Nobcha/R909-VFO-GPS/R909-VFO_GPS_connect3.jpg

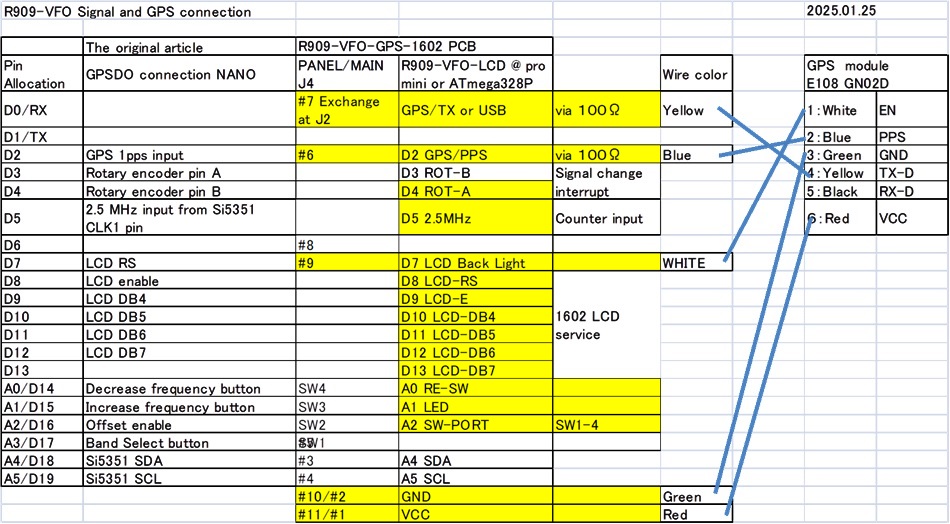
R909-VFO_GPS_connect3.jpg
