Nobcha/R909-VFO-GPS/R909-VFO_GPS_connect2.jpg

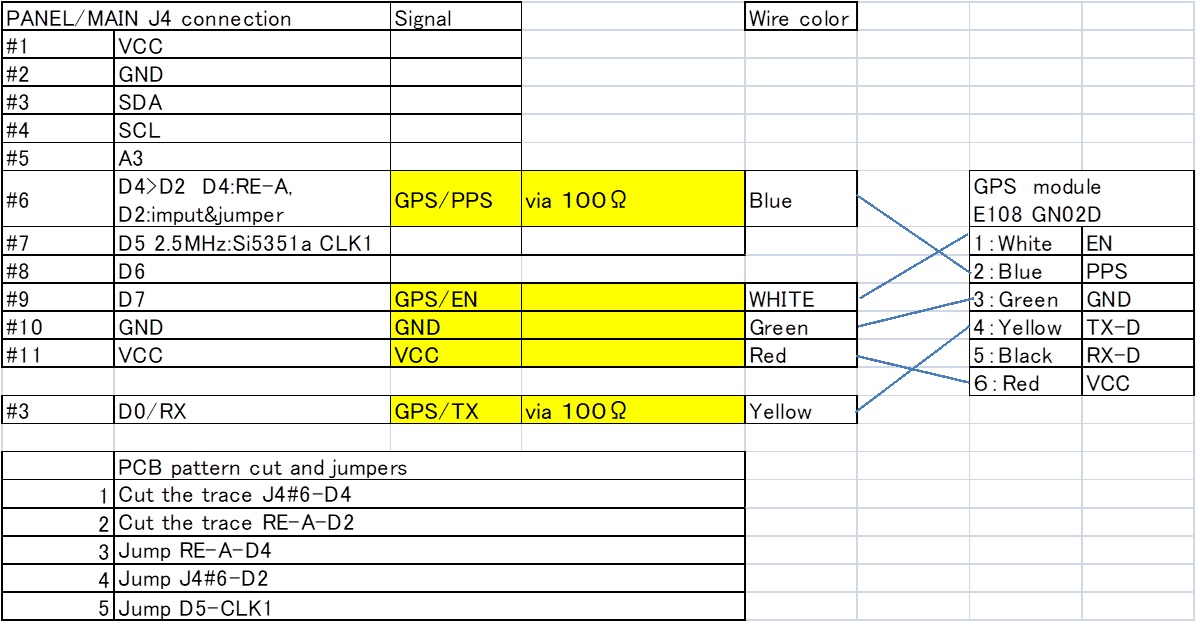
R909-VFO_GPS_connect2.jpg
