Nobcha/R909-VFO-GPS/R909-VFO_GPS_connection.jpg

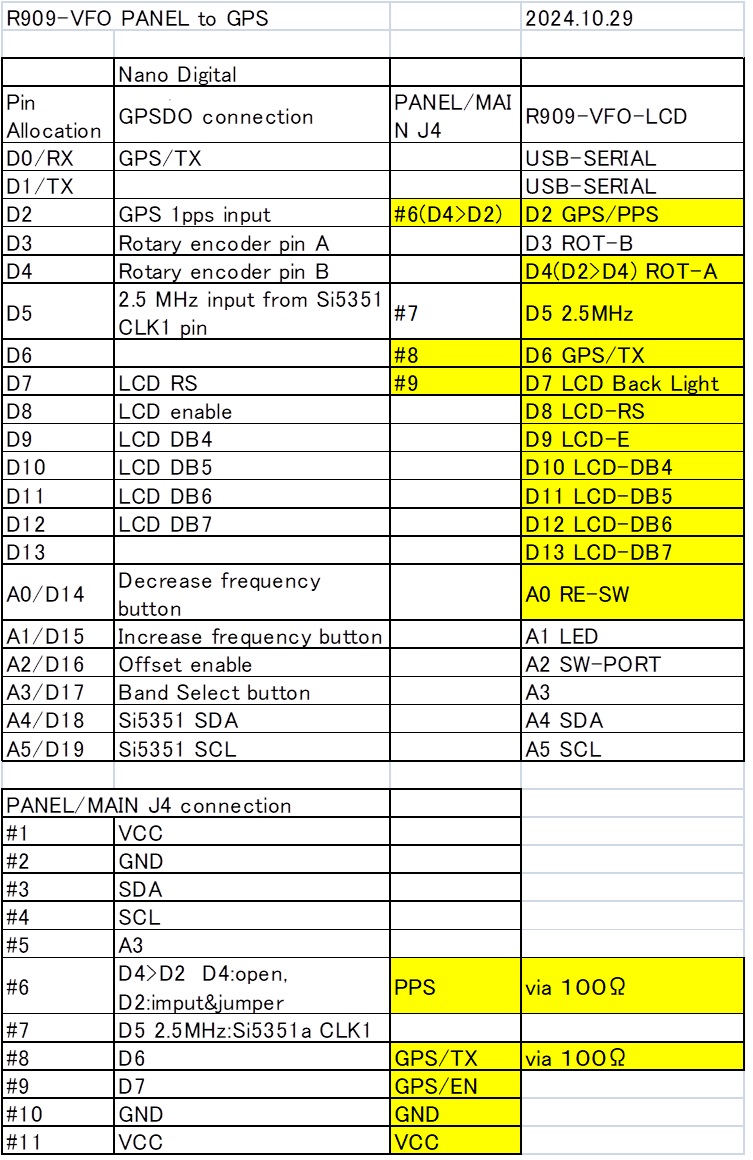
R909-VFO_GPS_connection.jpg
