Nobcha/R909-VFO-GPS/R909-VFO_GPS_bom.jpg

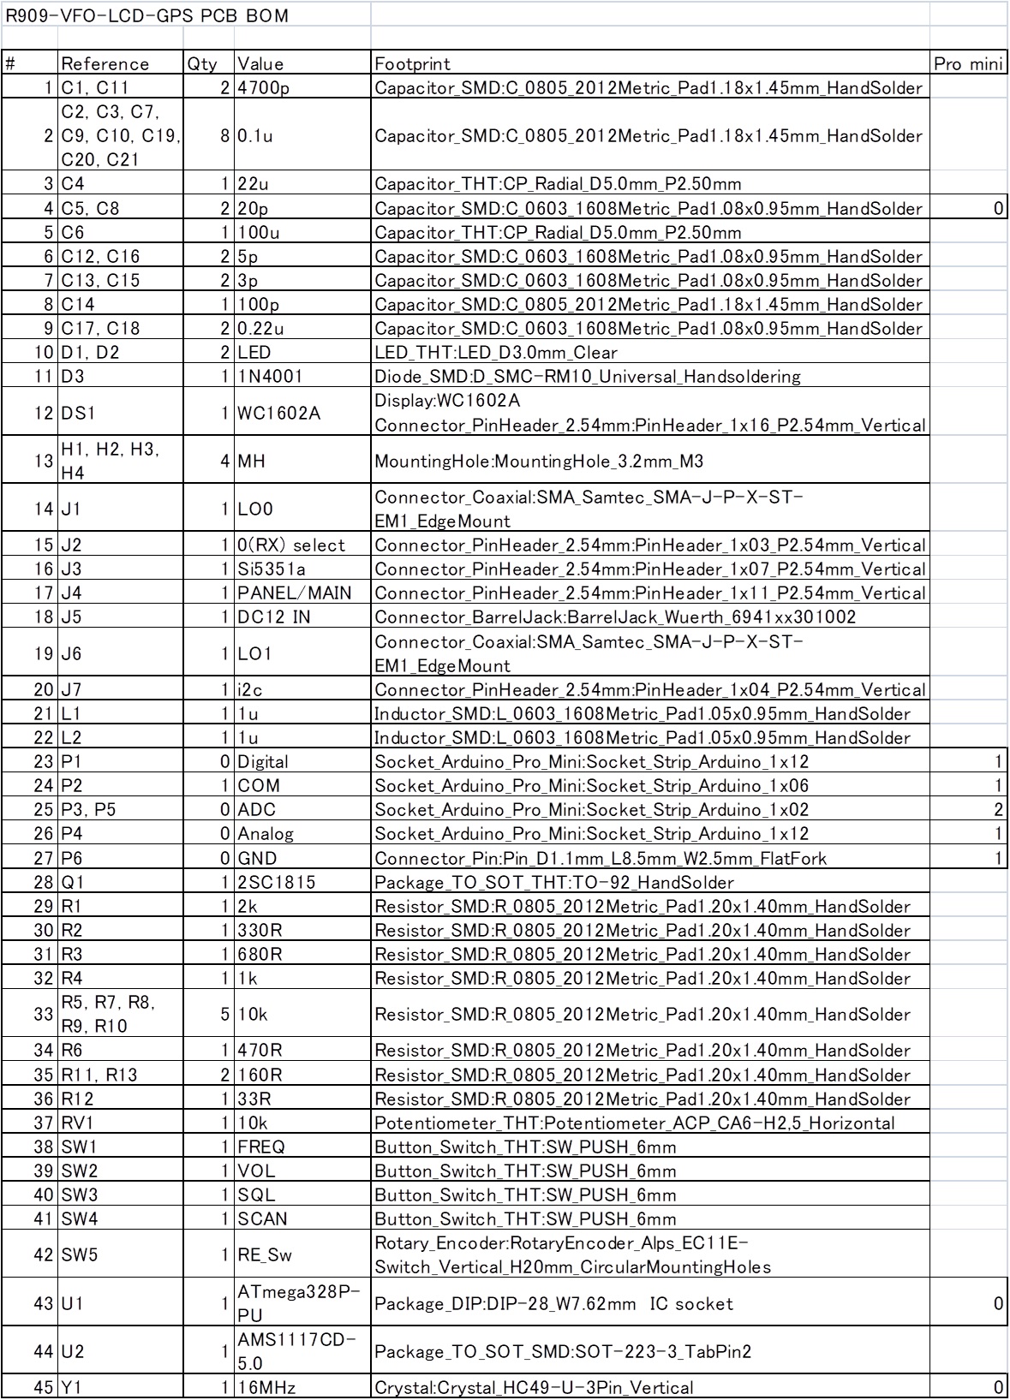
R909-VFO_GPS_bom.jpg
