Nobcha/R909-VFO-GPS/R909-VFO=GPS1602_manual_EN.pdf

Prototype of VFO that calibrates frequency using GPS

1.

I made a prototype VFO circuit that improves its accuracy.
method, it seems to be about
time. I found and read the relevant QEX article. useful for obtaining data for the F
of the R909
http://www.arrl.org/files/file/QEX_Next_Issue/2015/Ju So I
PANEL control unit (1602LCD display) board, which is

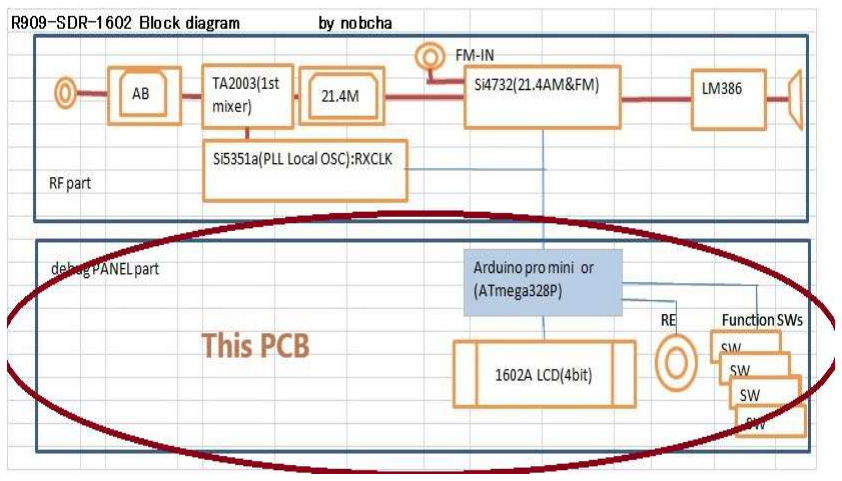
[picture p6: figure]

The GPS Corrected VFO works by using the GPS 1 secon outputs a frequency of 2.5MHz, counts for 40 seconds, a difference becomes the Si5351a VFO calibration data satellite

Prototype of VFO that calibrates frequency using GPS

Preface

I made a prototype VFO circuit that improves its accuracy.
method, it seems to be about
time. I found and read the relevant QEX article. useful for obtaining data for the F
of the R909-VFO function for each individual module. http://www.arrl.org/files/file/QEX_Next_Issue/2015/Ju modified the R909
PANEL control unit (1602LCD display) board, which is

The GPS Corrected VFO works by using the GPS 1 secon outputs a frequency of 2.5MHz, counts for 40 seconds, a difference becomes the Si5351a VFO calibration data
, and when the PPS signal is output, the calibration

The frequency error of the GPS signal is said to be

VFO function for each individual module.

-VFO I had on hand and

https://nobcha23.hatenablog.com/

The frequency error of the GPS signal is said to be -1/10,000,000

-COR (Si5351a reference oscillation frequ

VFO I had on hand and

https://nobcha23.hatenablog.com/

is calibrate

due to the influence of the stability of the crystal

COR (Si5351a reference oscillation frequ

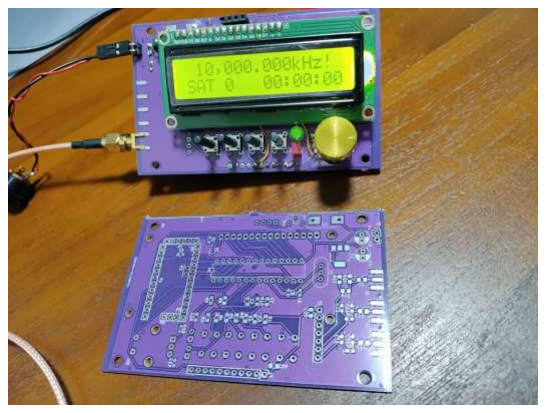
[picture p7: figure]
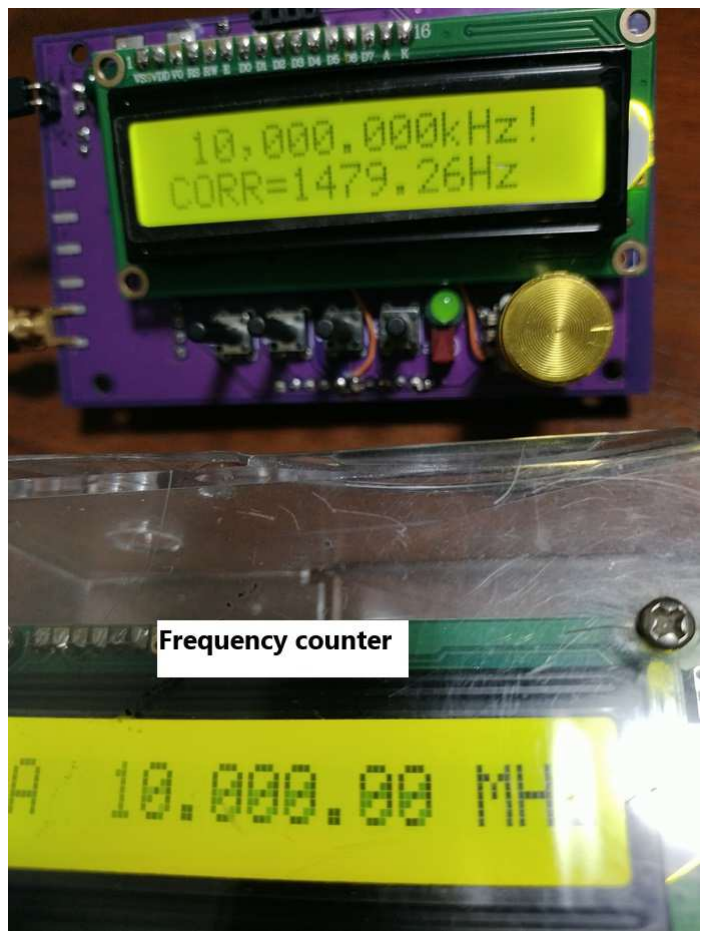
[picture p8: figure]

The 25MHz crystal oscillator of the Si5351a module is 1479.26Hz off from the GPS standard frequency when converted to 10MHz.

This is the calibrated 10MHz s
with a frequency counter calibrated with a 12.8MHz

data (using R909

d with a high

due to the influence of the stability of the crystal
This method obtains the calibration frequency, so it

l-Aug_2015/Marcus.pdf
diverted this function.
the local oscillator part of the R909

d puls
nd calculates the difference with 10,000,000.
. The GPS module captures radio waves from the

The 25MHz crystal oscillator of the Si5351a module is 1479.26Hz off from the GPS standard frequency when converted to 10MHz.

This is the calibrated 10MHz s
with a frequency counter calibrated with a 12.8MHz

data (using R909

-precision signal received from GPS and

Aug_2015/Marcus.pdf
ted this function.
the local oscillator part of the R909

d pulse PPS signal as a gate signal.
nd calculates the difference with 10,000,000.
. The GPS module captures radio waves from the frequency is obtained 44 seconds later.

-VFO board)

precision signal received from GPS and -1/10,000,

ency correction setting function)

The R909

ignal output. Read

©nobcha

0,000,000,000, but with this

-VFO comes from
-DSP

0, but with this
oscillator over
is also

comes from
DSP radio.

The Si5351a

TCXO.

is also

the

This

For the prototype and experimental GPS unit, we adopted the E108 GN02-D, which has a PPS signal terminal and is inexpensive.

The R909-VFO-Panel 1602 board used for prototyping and experiments has an ATmega328P or pro mini mounted as an Arduino, and the 1602LCD and GPS module are connected via the connection pin header. The J4 connector, originally prepared to connect this board to the RF board, is used to connect to the GPS module.

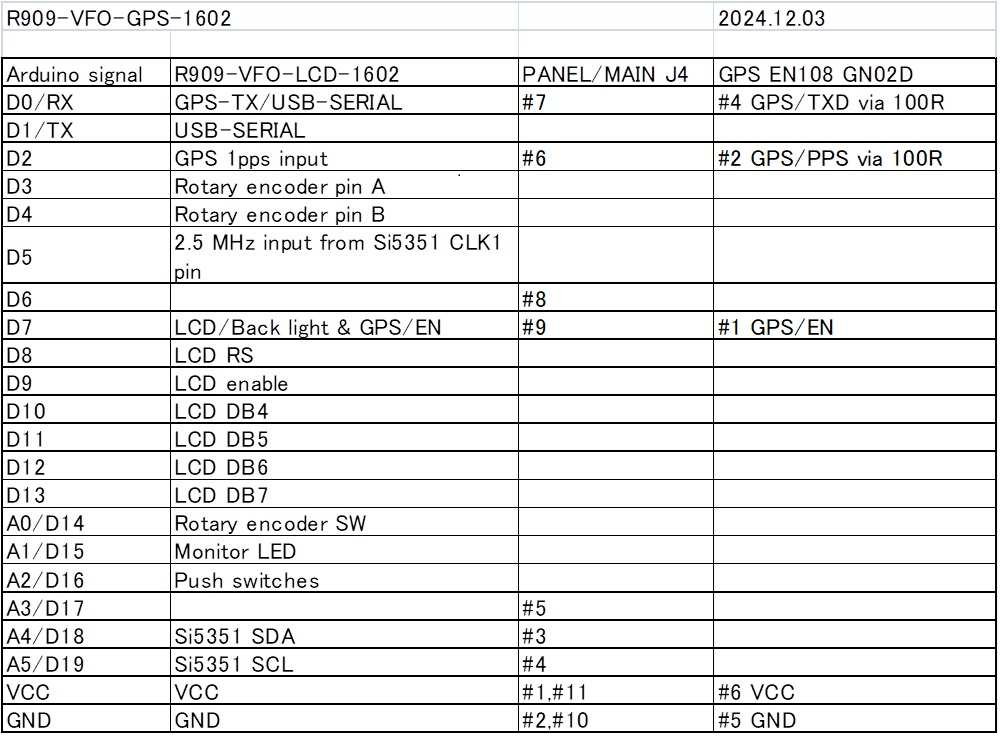
[picture p9: figure]

### 2. PCB

The circuit can be built using a universal board or breadboard. However, there are switches to operate, and I created a printed circuit board to ensure stable operation even if the GPS or Si5351a is removed and installed. The complete set of Gerber files for this board has been uploaded to GITHUB. It was output in standard specifications using the PCBGOGO KiCAD plugin. The bill of materials and circuit diagram are also in the same directory. Complete set of Gerber files for the board https://github.com/Nobcha/R909-VFO-GPS/blob/main/R909-VFO-LCD-GPS_rev.kicad_pcb.zip

### 3. Assembling

Refer to the parts list and circuit diagram and first solder the surface-mounted L, C, R and IC. Next, solder the DIP components: crystal, electrolytic capacitor, semi-fixed resistor, connector, IC socket, and LED. Finally, the SMA and switches.

Parts list: https://github.com/Nobcha/R909-VFO-GPS/blob/main/R909-VFO_GPS_bom.jpg
Circuit diagram: https://github.com/Nobcha/R909-VFO-GPS/blob/main/R909-VFO-GPS1602_scm.pdf

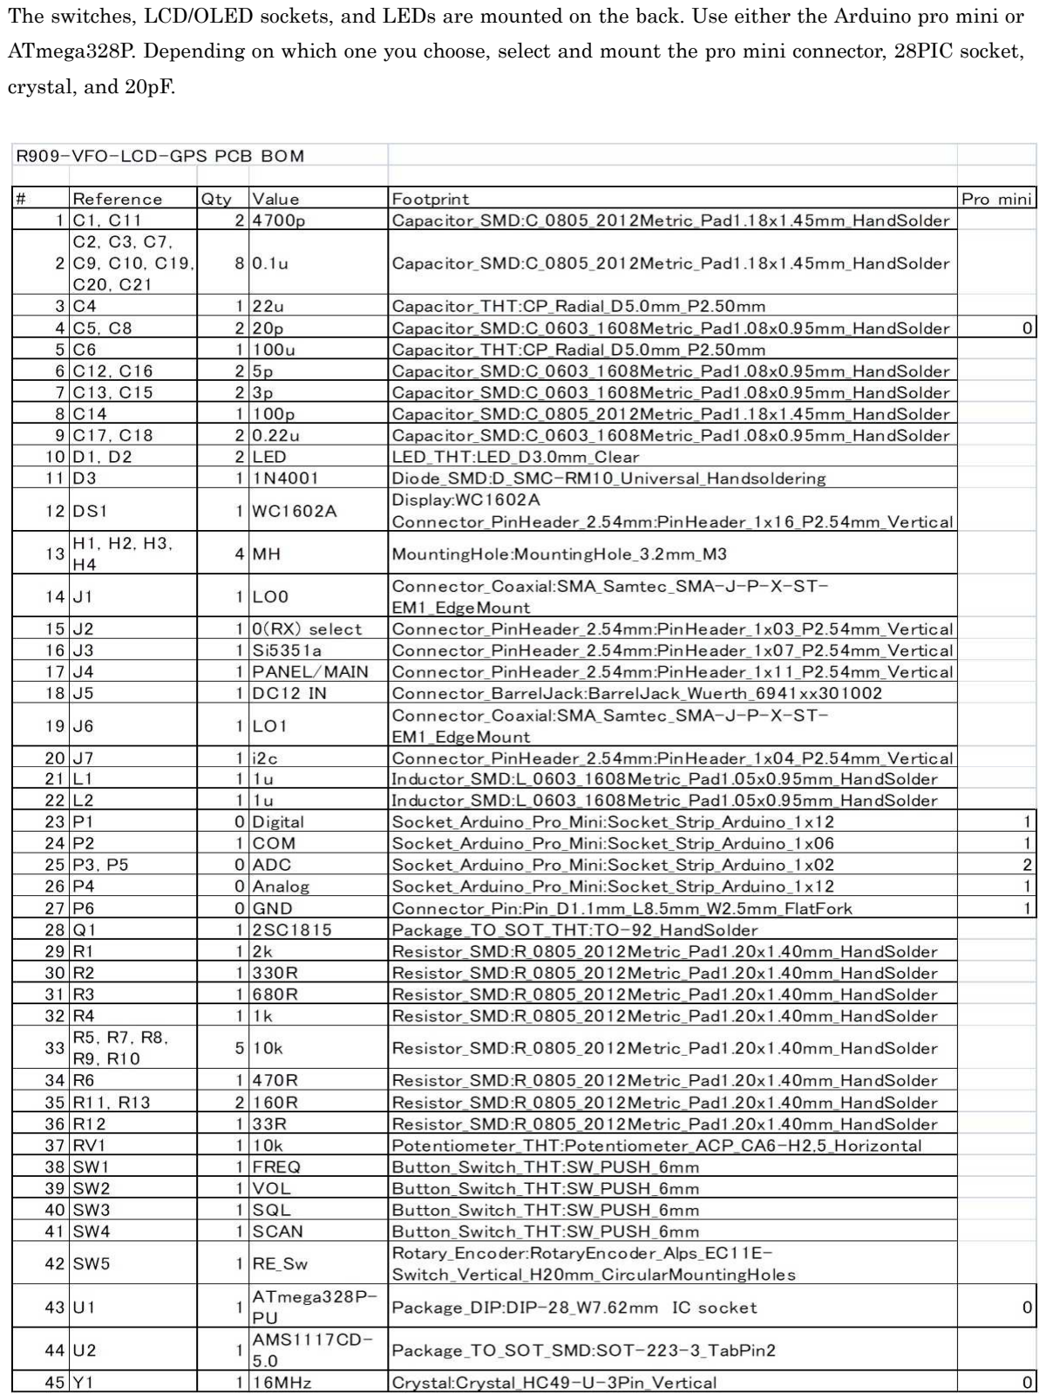
[picture p10: page 3]

The switches, LCD/OLED sockets, and LEDs are mounted on the back. Use either the Arduino pro mini or ATmega328P. Depending on which one you choose, select and mount the pro mini connector, 28PIC socket, crystal, and 20pF.

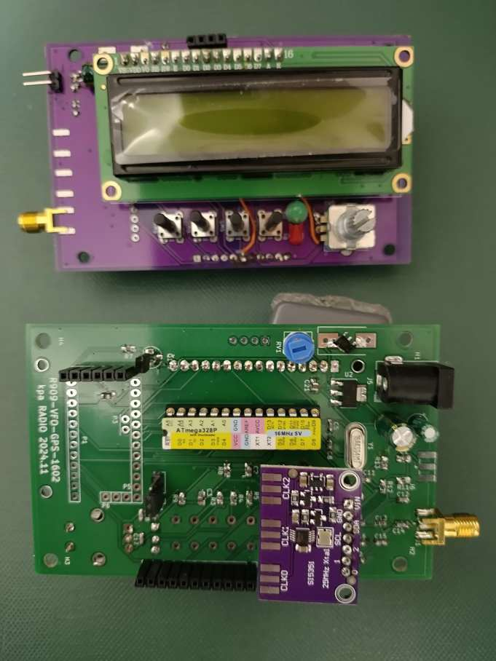
[picture p11: figure]

### 4. Sketch

I searched for a sketch to use as a reference and found a sketch by SQ1GU that was modified from a QEX article. http://sq1gu.tobis.com.pl/pl/syntezery-dds
Initially, I ported this sketch and carried out confirmation experiments. The following sketch is modified for the R909-VFO. https://github.com/Nobcha/R909-VFO-GPS/Si5351_GPS_kpa.ino

With this sketch, the rotary encoder operation did not go smoothly. After further searching, I found an improved version on GITHUB that made the rotary encoder contact input an interrupt. I downloaded this sketch, improved it to match the port settings to the R909-VFO board, and decided to modify and add functions.
gps-calibration-5351 https://github.com/csqwdy/gps-calibration-5351/blob/main/README.md
I have uploaded the sketch ported and improved for the R909-VFO to GITHUB.
GITHUB https://github.com/Nobcha/R909-VFO-GPS/blob/main/Si5351_GPS_kpa.ino

The points that were modified and improved from the original prototype sketch are:

① PPS was assigned to D2 and specified as an interrupt, and rotary encoder contact input was assigned to D3 and D4 and made into signal change interrupts.

② Correction frequency display function was added. In the original, the 25MHz oscillation of the Si5351a module was improved to TCXO. In this prototype, it remains a crystal oscillator and has poor stability over time. Therefore, since it is difficult to store the correction frequency in EEPROM at the threshold of 0.2Hz, a function was added to store the correction frequency in EEPROM when the rotary encoder is turned clockwise in Correction frequency display mode.

### 5. Usage

5.1 When the power is turned on, a banner with the name and version is displayed. Then it waits for a signal from the GPS unit. The GPS unit then waits for satellite capture. When a satellite is captured, the time is displayed. The number of satellites captured is displayed. When 4 or more satellites are captured stably, a PPS signal is output. When the PPS-LED on the GPS module starts flashing at 1-second intervals, it is in a stable reception state. When satellite capture is unstable, the PPS signal is sometimes lost. When it is lost, a ? is displayed after the frequency display. When data is updated smoothly from the GPS, a ! is displayed. It seems that stable reception cannot be achieved unless the GPS unit or antenna is taken outdoors.

5.2 When it is stable for 44 consecutive seconds and a PPS is output, the calibration frequency is calculated and used as the correction value. A considerable level of reception stability is required to not lose a PPS signal for 44 seconds. This correction value is a calibration value specific to the Si5351a module (10 MHz conversion), so it can be used as reference data when incorporating individual modules.

5.3 The calibration frequency is calculated, and the fluctuation range of the calibration frequency is calculated as the F STAB value. When the F STAB value becomes ±0.2Hz or less, the calibration frequency correction is stored in the EEPROM. It will be reflected the next time the power is turned on. When the rotary encoder is turned clockwise in the correction display mode, the calibration frequency correction is stored in the EEPROM.

5.4 JST (Japan Standard Time) is 9 hours earlier than Greenwich Mean Time, so set the TIME zone to +9.

5.5 There are 5 banks. The initial values are 1: 10MHz, 2: 16.7MHz, 3: 37.2MHz, 4: 64.8MHz, and 5: 145MHz. The setting value is stored in the EEPROM for each bank.

5.6 Eight types of step frequencies can be selected: 1, 10, 100Hz, 1, 10, 100KHz, and 1, 10MHz.

5.7 When in Bank mode, turning the rotary encoder increases or decreases the frequency of the specified bank in STEP frequency units. The set frequency value is stored in the EEPROM for each bank and will be recalled the next time the power is turned on.

5.8 Press and hold RE-SW while turning on the power to initialize the EEPROM and start up.

YOUTUBE https://www.youtube.com/shorts/6HuBzLwyKoM

The operation flow is summarized in a flowchart below.

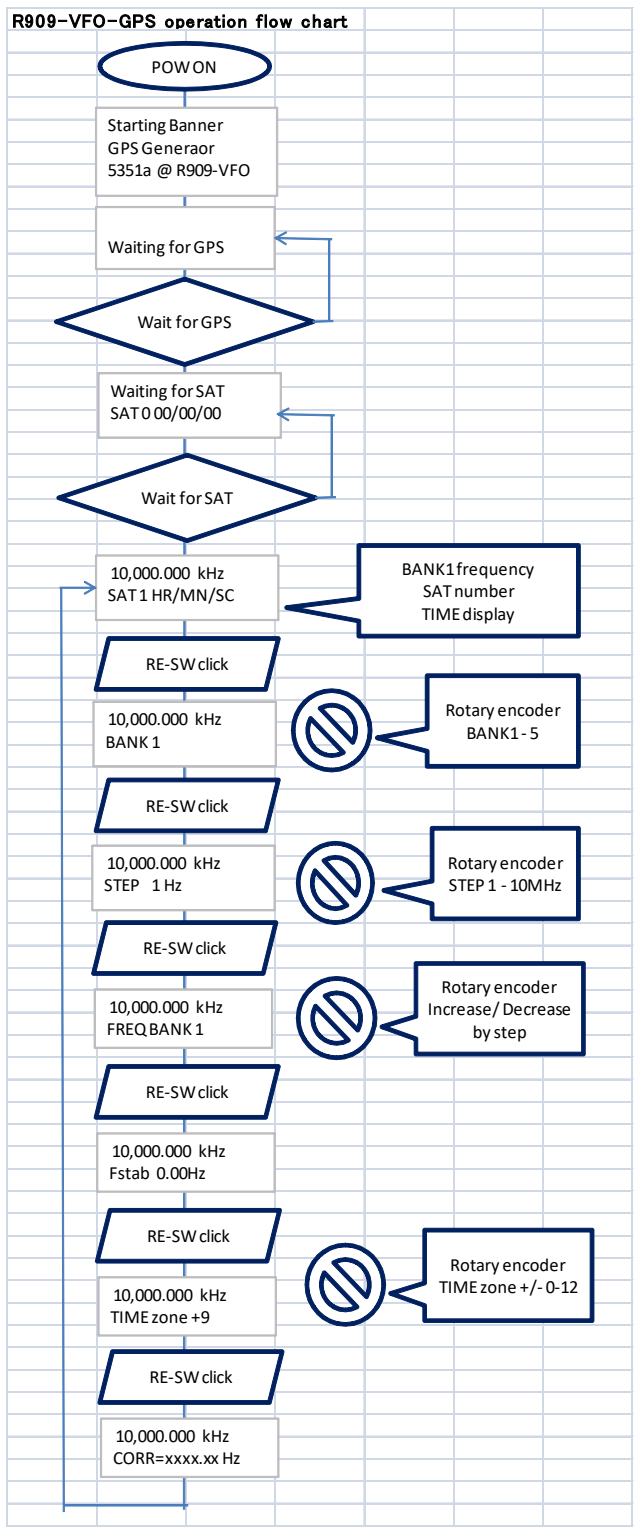
[picture p12: figure]
R909-VFO-GPS operation flow chart; POW ON; Starting Banner GPS Generaor 5351a @ R909-VFO; Waiting for GPS; Wait for GPS; Waiting for SAT SAT 0 00/00/00; Wait for SAT; 10,000.000 kHz; BANK1frequency; SAT 1 HR/MN/SC; SAT number; TIME display; RE-SW click; Rotary encoder; BANK 1; BANK1 - 5; kHz; STEP 1 Hz; STEP 1 - 10MHz; Increase/ Decrease; FREQ BANK 1; by step; 10,000.000 kHz Fstab 0.00Hz; TIME zone +/- 0-12; TIME zone +9; 10,000.000 kHz CORR=xxxx.xx Hz

### 6. References and Acknowledgements

In carrying out this prototype and experiment, we obtained and used as reference information from various websites on the Internet. We would like to thank the Arduino library authors, the information providers on GITHUB, and others. (The sources are listed in the text.)
The prototype board was also created with the cooperation of PCBGOGO.
