Nobcha/R909-VFO-GPS/R909-VFO=GPS1602_manual_JA.pdf

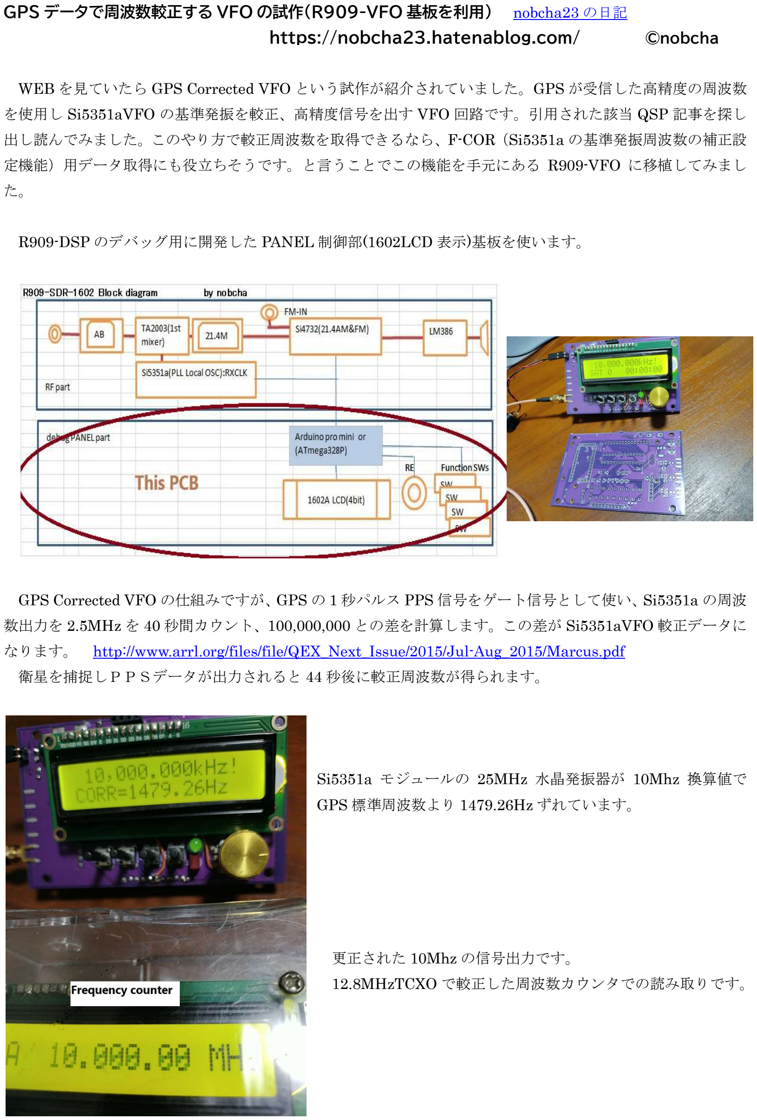
[picture p13: page 1]

GPS

WEB
を使用
出し
定機能）用データ取得に
た。

R909

GPS Corrected VFO
数出力を
なります
衛星を捕捉しＰＰＳデータが出力されると

データで周波数較正する

WEB を見ていたら
し Si5351aVFO
読んでみました。このやり方
定機能）用データ取得に

R909-DSP のデバッグ

GPS Corrected VFO
2.5MHz
。 http://www.arrl.org/files/file/QEX_Next_Issue/2015/Jul 衛星を捕捉しＰＰＳデータが出力されると

GPS Corrected VFO
の基準発振を
ました。このやり方
も

のデバッグ用に開発した

の仕組みですが、
を 40 秒間カウント、
http://www.arrl.org/files/file/QEX_Next_Issue/2015/Jul

VFO の試作

GPS Corrected VFO
の基準発振を較正
で較正周波数
役立ちそうです。と言うことでこの機能を

用に開発した

の仕組みですが、
秒間カウント、

の試作（R909
https://nobcha23.hatenablog.com/

という試作が紹介されて
較正、高精度信号を出す
を取得できるなら、

PANEL 制御部

GPS の１秒パルス
100,000,000

### 44 秒後に較正周波数が得られます。

Si5351a
GPS

更正された
12.8MHzTCXO

-VFO 基板を利用）

取得できるなら、

(1602LCD

の１秒パルス PPS
との差を

秒後に較正周波数が得られます。

5351a モジュールの
標準周波数より

更正された 10Mhz
12.8MHzTCXO

基板を利用）

いました。
VFO 回路で
F-COR
手元にある

表示)基板を使います。

PPS 信号をゲート信号
計算します。この差が
-Aug_2015/Marcus.pdf

モジュールの 25MHz
1479

10Mhz の信号出力です。
で較正した周波数カウンタで

nobcha23

GPS
す。引用された
（Si5351a
手元にある R909

基板を使います。

として

Aug_2015/Marcus.pdf

25MHz 水晶発振器
.26Hz ずれています。

の信号出力です。

の日記

が受信した高精度の周波数
該当 QSP
の基準発振周波数の補正設
-VFO に移植してみまし

として使い、
Si5351aVFO

が 10Mhz
れています。

の読み取りで

©nobcha

QSP 記事を探し

に移植してみまし

Si5351a の周波
較正データに

10Mhz 換算値で

の読み取りで

の周波

す。

では試作・実験に取り掛かります。まずは GPS ユニットを買います。PPS 信号端子があり安価だった E108 GN02-D にしました。元ネタでは GPS ユニットと Arduino はハードウェアシリアル接続です。しかし、デバッ グでシリアルポートは確保したいと思ったので、手始めの実験ではＧＰＳとの接続は SoftwareSerial を使用す ることにしました。

試作・実験に使う R909-VFO-Panel 1602 基板には Arduino として ATmega328P あるいは pro mini が載って いて、1602LCD、GPS モジュールを接続ピンヘッダー経由でつなぎます。そして、元々はこの基板と RF 基板 をつなぐための J4 コネクタ、IDE 接続用シリアル USB の RXD 端子を GPS モジュールと繋ぐために使います。

### 1. 基板作成

ユニバーサル基板やブレッドボードで回路を組める程度の構成です。しかし、スイッチ操作や GPS や Si5351a の取り外しなどしても安定動作させたく、プリント基板を作りました。基板のガーバーファイル一式 は GITHUB にアップロードしてあります。PCBGOGO の KiCAD プラグインで出力したものです。部品表、 回路図も同じディレクトリーに置いてあります。
基板のガーバーファイル一式
https://github.com/Nobcha/R909-VFO-GPS/blob/main/R909-VFO-GPS1602_scm.pdf 部品表 https://github.com/Nobcha/R909-VFO-GPS/blob/main/R909-VFO_GPS_bom.jpg 回路図 https://github.com/Nobcha/R909-VFO-GPS/blob/main/R909-VFO-GPS1602_scm.pdf

### 2. SoftwareSerial で事前接続実験

GPS 受信動作やデータがどうなっているのかをまずは SoftwareSerial でつないで事前接続実験をしてみまし た。使用するライブラリの準備も兼ねて行いました。

2..1 ライブラリ TinyGPS++のダウンロード
GitHub mikalhart から TinyGPSPlus ライブラリをダウンロード。 https://github.com/mikalhart/TinyGPSPlus/releases ダウンロードした、”TinyGPSPlus-1.0.2b.zip”を Arduino IDE へインクルード

### 2.2. WEB のページを参考に GPS との接続確認スケッチを作成。

このユニットには EN 端子が付いていて、LOW にすると SLEEP になるので、HIGH にするため、LCD バックライトのポート信号を流用しました。

### 2.3.1 GPS 時計を移植する

スケッチ | https://github.com/Nobcha/R909-VFO-GPS/blob/main/GPS_watch_kpa.ino
元の参照した WEB | よかひより ざぼんさん | https://yokahiyori.com/arduino_gps_lcd_clock/

### 2.3.2. 緯度、経度

続いて、GPS からの NMEA0183 コマンドを解析し緯度、経度などのデータを取得し、LCD に表示して みます。

https://github.com/Nobcha/R909-VFO-GPS/blob/main/GPS_TEST20241022_3.ino

注意：スケッチのデバッグには衛星捕捉が必要です。窓際か庭先に置きしばらく待ちます。数分ぐらいすると pps の LED が光り始める共に経度緯度など取得でき表示できました。

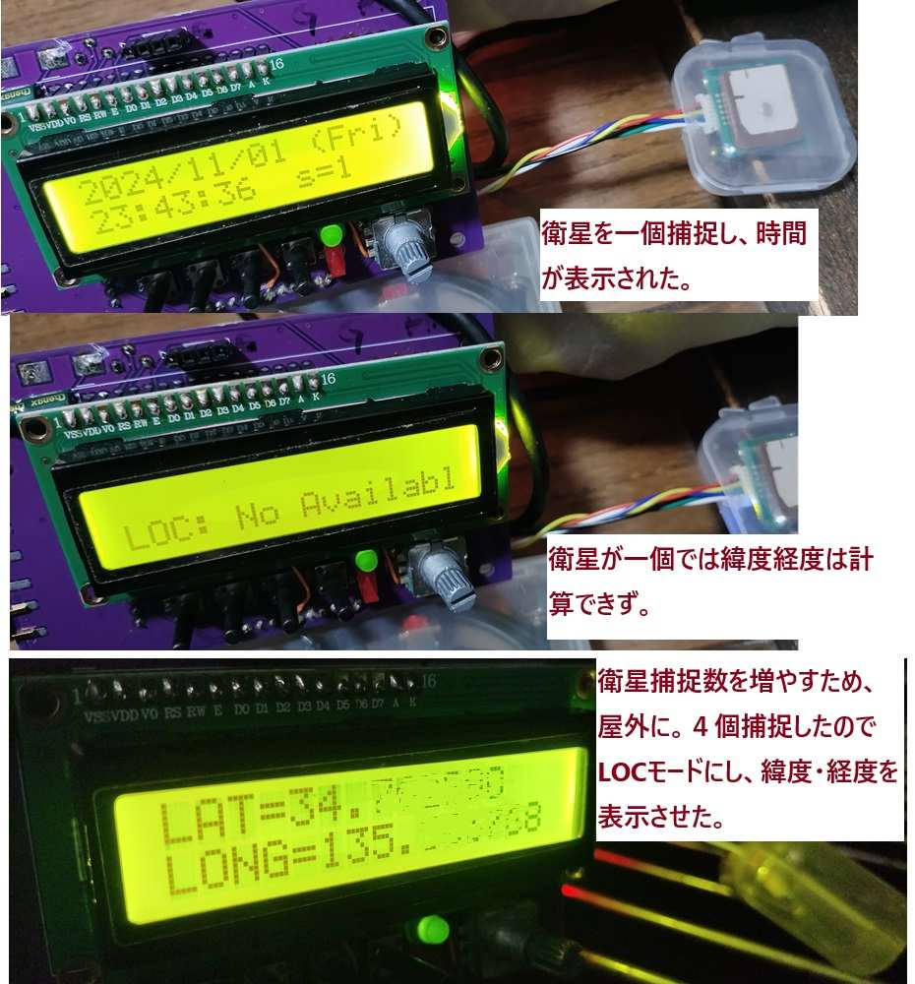
[picture p14: figure]

GPS_TEST20241022_3.ino の実行結果

### 3. ハードウェアシリアル接続に切り替え ORIGINAL スケッチは SQ1GU 版を参照。

以上の事前実験を経て、GPS の使い方が判ってきました。次に参考スケッチを探します。QEX 記事を引用改 良した SQ1GU さんのスケッチがありました。 http://sq1gu.tobis.com.pl/pl/syntezery-dds はじめはこのスケッチを移植し確認実験を進めました。
https://github.com/Nobcha/R909-VFO-GPS/Si5351_GPS_kpa.ino

更に探すと、ロータリエンコーダ接点入力を割り込みにした改良版が GITHUB にありました。このスケッチ をダウンロードしポート設定を R909-VFO 基板に合わせ、改良修正追加することにしました。 gps-calibration-5351 https://github.com/csqwdy/gps-calibration-5351/blob/main/README.md

R909‐VFO 用に移植、改良したスケッチを GITHUB にアップロードしました。

GITHUB https://github.com/Nobcha/R909-VFO-GPS/blob/main/Si5351_GPS_kpa.ino

オリジナルの試作、スケッチから修正・改良を行なった点は
① D2 に PPS を割り当て割り込み指定し、D3,D4 にはロータリエンコーダ接点入力を割り当て信号変化割り込 みにした、

② Correction 周波数表示機能を追加、
元ネタでは Si5351a モジュールの 25MHz 発振を TCXO に改良している。この試作では水晶発振器のまま であり経時安定度が悪い。なので、EEPROM へ correction 周波数を記憶する閾値 0.2Hz ではなかなか記憶 しないので、Correction 周波数表示モード時にロータリエンコーダを時計方向に回すと較正周波数 correction を EEPROM に記憶する機能を追加しました。

### 4. 使い方

### 4.1 電源を投入し、GPS ユニットは屋外に出します。衛星を 4 以上安定して捕捉すると PPS 信号がでます。

GPS モジュールの PPS－LED が 1 秒間隔で点滅し始めると安定受信状態です。衛星の捕捉が安定しないと きは、時々PPS 信号が欠落します。欠落時には周波数表示の後に？を表示します。GPS からデータ更新が円 滑に行われているときは！を表示します。

4.2 44 秒間安定して PPS が出ると、較正周波数を算出し correction 値とします。44 秒間 PPS 信号が欠落 しないというのは結構な受信安定度が必要です。この correction 値は Si5351a モジュールの固有の較正値 (10Mhz 換算)ですので、個別モジュール組み込み時の参考データになります。

### 4.3 較正周波数が計算され、また、較正周波数の変動幅が F STAB 値として計算されます。F STAB 値が

±0.2Hz 以下になると較正周波数 correction を EEPROM に記憶します。次に電源を入れた時に反映されま す。Correction 表示モードの時にロータリエンコーダを時計方向に回すと較正周波数 correction を EEPROM に記憶します。

### 4.4 JST（日本標準時）はグリニッジ標準時に対して 9 時間早いので TIME zone を+9 に設定します。

### 4.5 BANK として 1－5 まであります。1：10MHｚ、2：16.7MHｚ、3：37.2MHｚ、4：64.8MHｚ、5：

145MHｚとなっています。設定値は各 BANK 毎に EEPROM に記憶されます。

### 4.6 STEP 周波数は 1，10，100Hz、1，10，100KHz、1，10MHｚの 8 種類が選べます。

### 4.7 FREQ Bank モードの時にロータリエンコーダを回すと、STEP 周波数単位で指定 BANK の周波数を

増減できます。設定した周波数値は EEPROM に記憶され、次回電源オン時には呼び出されます。

### 4.8 RE-SW を押しながら電源を投入すると EEPROM を初期化して立ち上がります。

操作の流れをフローチャートにまとめました。

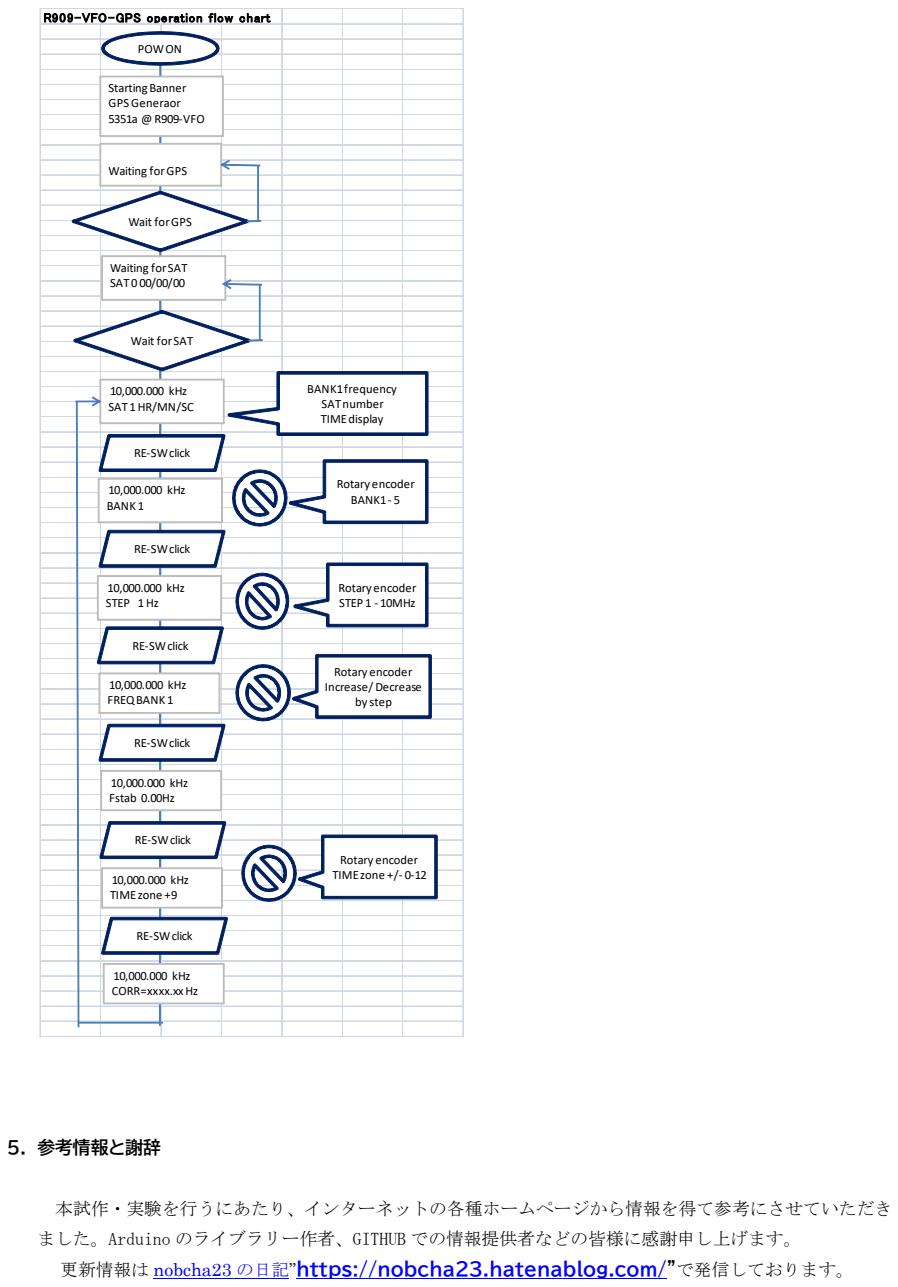
[picture p15: page 5]
5. 参考情報と謝辞; POW ON

R909-VFO-GPS operation flow chart

Starting Banner
GPS Generaor
5351a @ R909-VFO

Waiting for GPS

Wait for GPS

Waiting for SAT
SAT 0 00/00/00

Wait for SAT

10,000.000 kHz | | BANK1frequency
SAT 1 HR/MN/SC | | SAT number

TIME display

RE-SW click

10,000.000 kHz | Rotary encoder
BANK 1 | | BANK1 - 5

10,000.000 | kHz | Rotary encoder
STEP 1 Hz | | | STEP 1 - 10MHz

Rotary encoder

10,000.000 kHz | Increase/ Decrease
FREQ BANK 1 | | by step

10,000.000 kHz
Fstab 0.00Hz

10,000.000 kHz | TIME zone +/- 0-12
TIME zone +9

CORR=xxxx.xx Hz

本試作・実験を行うにあたり、インターネットの各種ホームページから情報を得て参考にさせていただき
ました。Arduino のライブラリー作者、GITHUB での情報提供者などの皆様に感謝申し上げます。
更新情報は nobcha23 の日記”https://nobcha23.hatenablog.com/”で発信しております。

本試作は nobcha の個人的な興味の範疇で行っております。商用利用を意図したものではありません。な お、記事中にはアフィリエートやプロモーションが含まれていることをご承知願います。また、著作権を維 持するため、引用などされる場合は一報いただけると幸いです。 nobcha４８＠gmail.com （半角にしてお使いください）
