Nobcha/R909-VFO-GPS/R909-VFO-GPS1602_scm.pdf

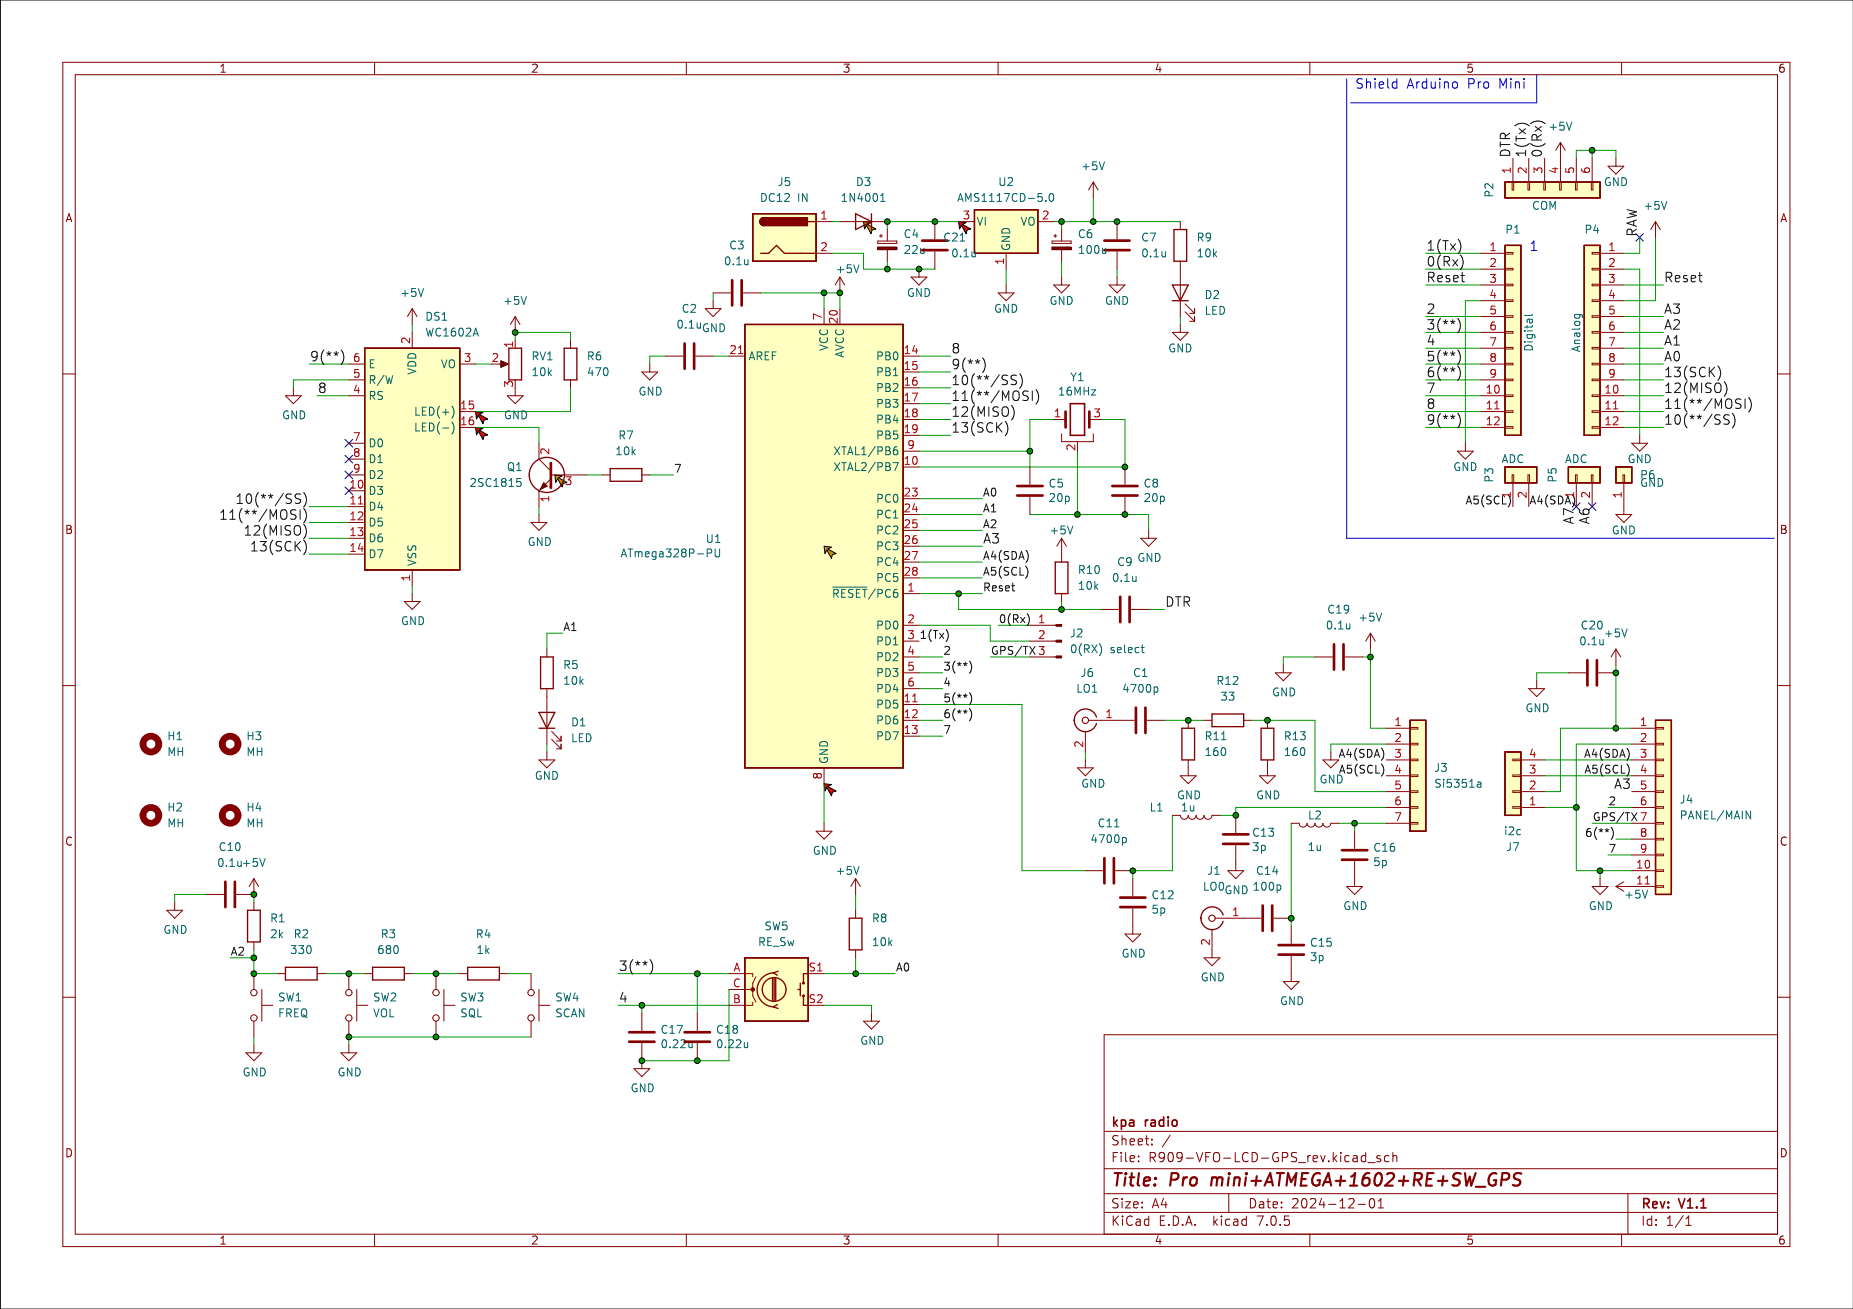
[picture p16: page 1]
