Nobcha/R909-VFO-GPS/(commit log)

2024-10-29 R909-VFO remodelled schematic for connecting with GPS
2024-10-29 Diverted sketch fo R909-VFO
    GPS corrected VFO on R909-VFO-1602 PCB
    [Si5351_GPS-kpa.ino]
2024-10-29 Update Si5351_GPS-kpa.ino
    GPS corrected VFO
    [Si5351_GPS-kpa.ino]
2024-11-01 Time & Location monitor by R909-VFO
2024-11-16 GPS corrected VFO on R909-VFO board
    I added GPS correction ability on my R909-VFO board which is composed with Arduino pro mini, Si5351a module, and1602A LCD. I would like to use this for getting error frequency value for each Si5351a module.
    [Si5351_GPS_kpa.ino]
2024-11-16 Update README.md
    SQ1GU試作スケッチを移植搭載しました。
2024-11-22 R909-VFO-GPS schematic
    Using the signal change interrupt for PPS and rotary encoder.
2024-12-01 BOM for R909-VFO-GPS1602 PCB
    PCB Gerber zip files for VFO corrected by GPS on R909-VFO
2024-12-01 Schematics for R909-VFO-GPS1602
    The schematics for R909-VFO
2024-12-01 Cerber format files for R909-VFO-GPS1602
    PCB production files of R909-VFO-GPS.
2024-12-01 R909-VFO-GPS1602版の日本語マニュアル
    基板データ、スケッチ、操作などの説明書です。
2024-12-01 Update README.md
    I designed the PCB for this project. I uploaded the Gerber files.
2024-12-04 Assembling and operating manual in English
